LordBrain/SpacePointer/RaspberryPi/config.py

# Your site location
# Use this site: http://www.latlong.net/
siteLat = 44.9754421 #+North (Minneapolis,MN)
siteLon = -93.2820799 #+East (Minneapolis,MN)
siteAlt = 267 #meters (Minneapolis,MN)

serialSpeed = 38400
serialPort = '/dev/ttyACM0'
